chadr/Heathkit-IT-121-Power-Supply/KICAD/1043/3D/1043.stp

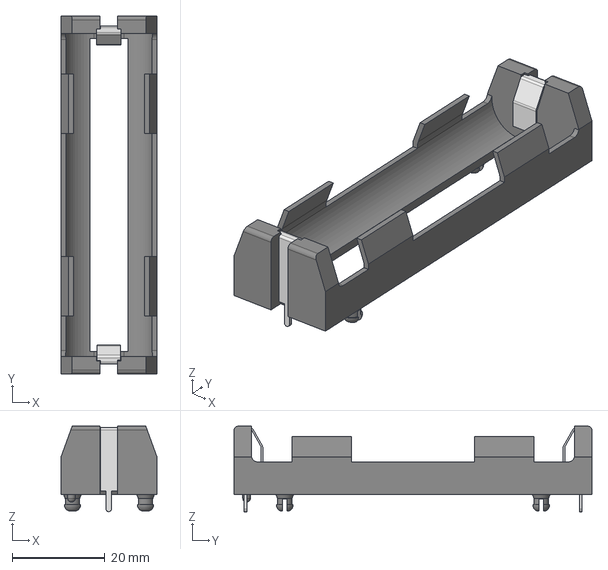
[picture p4: CAD file, 2025-03-20]
KICAD/1043/3D/1043.stp
20.6 x 77.0 x 18.4 mm
