chadr/Heathkit-IT-121-Power-Supply/(list of files, cad)

Other CAD files:
KICAD/1043/Allegro/1043.psm
KICAD/1043/DEHDL/1043/chips/chips.prt
