chadr/Heathkit-IT-121-Power-Supply/(list of files, drawings)

Other design files:
KICAD/1043/Altium/1043.PcbLib
KICAD/1043/Altium/1043.SchLib
