chadr/Heathkit-IT-121-Power-Supply/KICAD/HeathkitBatteryEliminator/HeathkitBatteryEliminator.kicad_pcb

## KiCad design KICAD/HeathkitBatteryEliminator/HeathkitBatteryEliminator.kicad_pcb (2025-03-20)

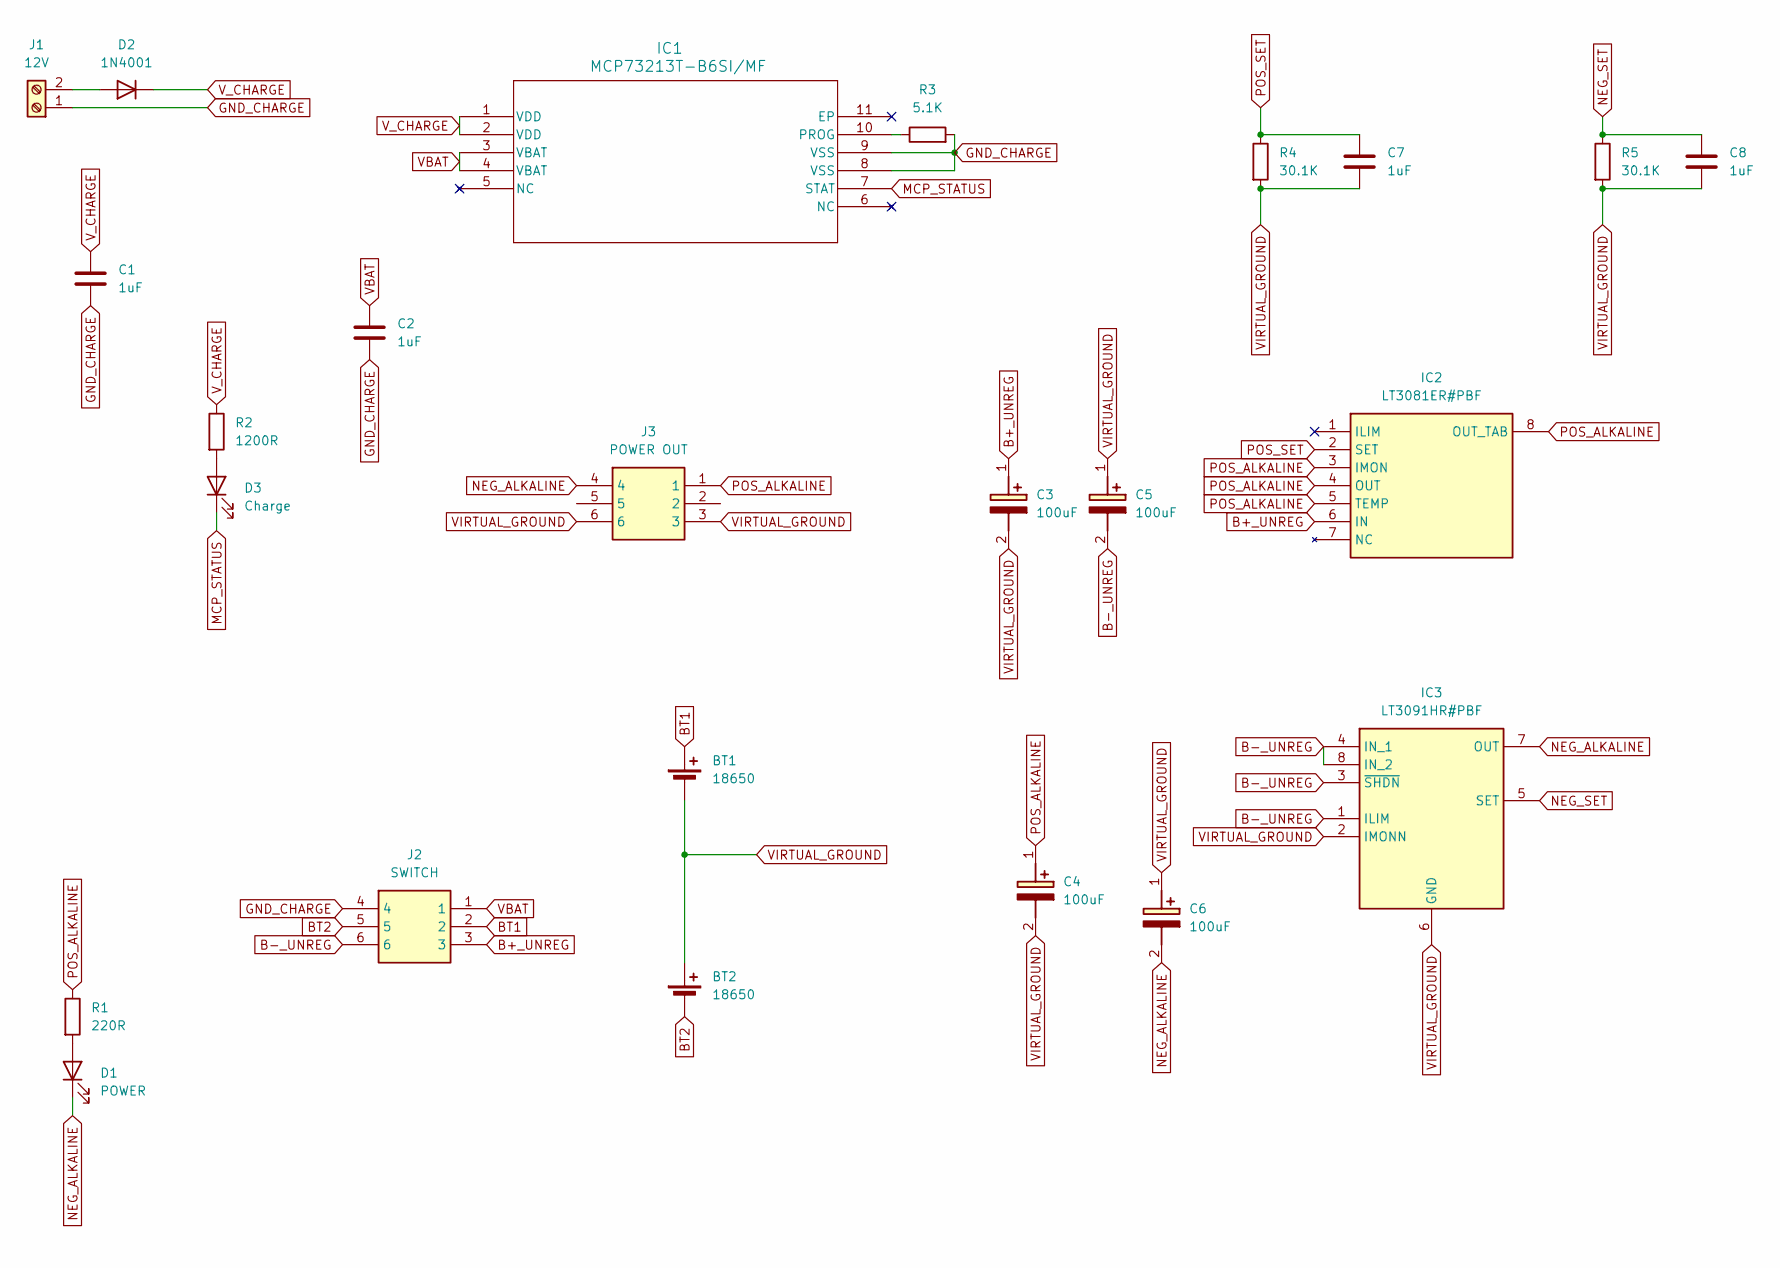
[picture p5: schematic HeathkitBatteryEliminator.kicad_sch]

Parts:
BT1, BT2: 18650; 1043
C1, C2: 1uF; C_0603_1608Metric_Pad1.08x0.95mm_HandSolder
C3, C4, C5, C6: 100uF; 865080343009; Manufacturer_Part_Number 865080343009; Mouser Part Number 710-865080343009
C7, C8: 1uF; C_0603_1608Metric
D1: POWER; PinHeader_2x01_P2.54mm_Vertical
D2: 1N4001; D_DO-41_SOD81_P10.16mm_Horizontal
D3: Charge; PinHeader_2x01_P2.54mm_Vertical
IC1: MCP73213T-B6SI/MF; DFN10_3x3MC_MCH-M
IC2: LT3081ER#PBF; TO127P1394X457-8N; Manufacturer_Part_Number LT3081ER#PBF; Mouser Part Number 584-LT3081ER#PBF
IC3: LT3091HR#PBF; LT3091HRPBF; Manufacturer_Part_Number LT3091HR#PBF; Mouser Part Number 584-LT3091HR#PBF
J1: 12V; TerminalBlock_Phoenix_MKDS-1,5-2-5.08_1x02_P5.08mm_Horizont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
J2: SWITCH; 455580003; Manufacturer_Part_Number 45558-0003; Mouser Part Number 538-45558-0003
J3: POWER OUT; 455580003; Manufacturer_Part_Number 45558-0003; Mouser Part Number 538-45558-0003
R1: 220R; R_0603_1608Metric
R2: 1200R; R_0603_1608Metric
R3: 5.1K; R_0603_1608Metric
R4, R5: 30.1K; R_0603_1608Metric

Connections:
B+_UNREG: C3.1 (+), IC2.6 (IN), J2.3
B-_UNREG: C5.2 (-), IC3.1 (ILIM), IC3.3 (~SHDN), IC3.4 (IN_1), IC3.8 (IN_2), J2.6
BT1: BT1.1 (+), J2.2
BT2: BT2.2 (-), J2.5
GND_CHARGE: C1.2, C2.2, IC1.8 (VSS), IC1.9 (VSS), J1.1, J2.4, R3.2
MCP_STATUS: D3.1 (K), IC1.7 (STAT)
NEG_ALKALINE: C6.2 (-), D1.1 (K), IC3.7 (OUT), J3.4
NEG_SET: C8.1, IC3.5 (SET), R5.1
unnamed: D1.2 (A), R1.2
unnamed: D2.2 (A), J1.2
unnamed: D3.2 (A), R2.2
unnamed: IC1.10 (PROG), R3.1
POS_ALKALINE: C4.1 (+), IC2.3 (IMON), IC2.4 (OUT), IC2.5 (TEMP), IC2.8 (OUT_TAB), J3.1, R1.1
POS_SET: C7.1, IC2.2 (SET), R4.1
VBAT: C2.1, IC1.3 (VBAT), IC1.4 (VBAT), J2.1
VIRTUAL_GROUND: BT1.2 (-), BT2.1 (+), C3.2 (-), C4.2 (-), C5.1 (+), C6.1 (+), C7.2, C8.2, IC3.2 (IMONN), IC3.6 (GND), J3.3, J3.6, R4.2, R5.2
V_CHARGE: C1.1, D2.1 (K), IC1.1 (VDD), IC1.2 (VDD), R2.1

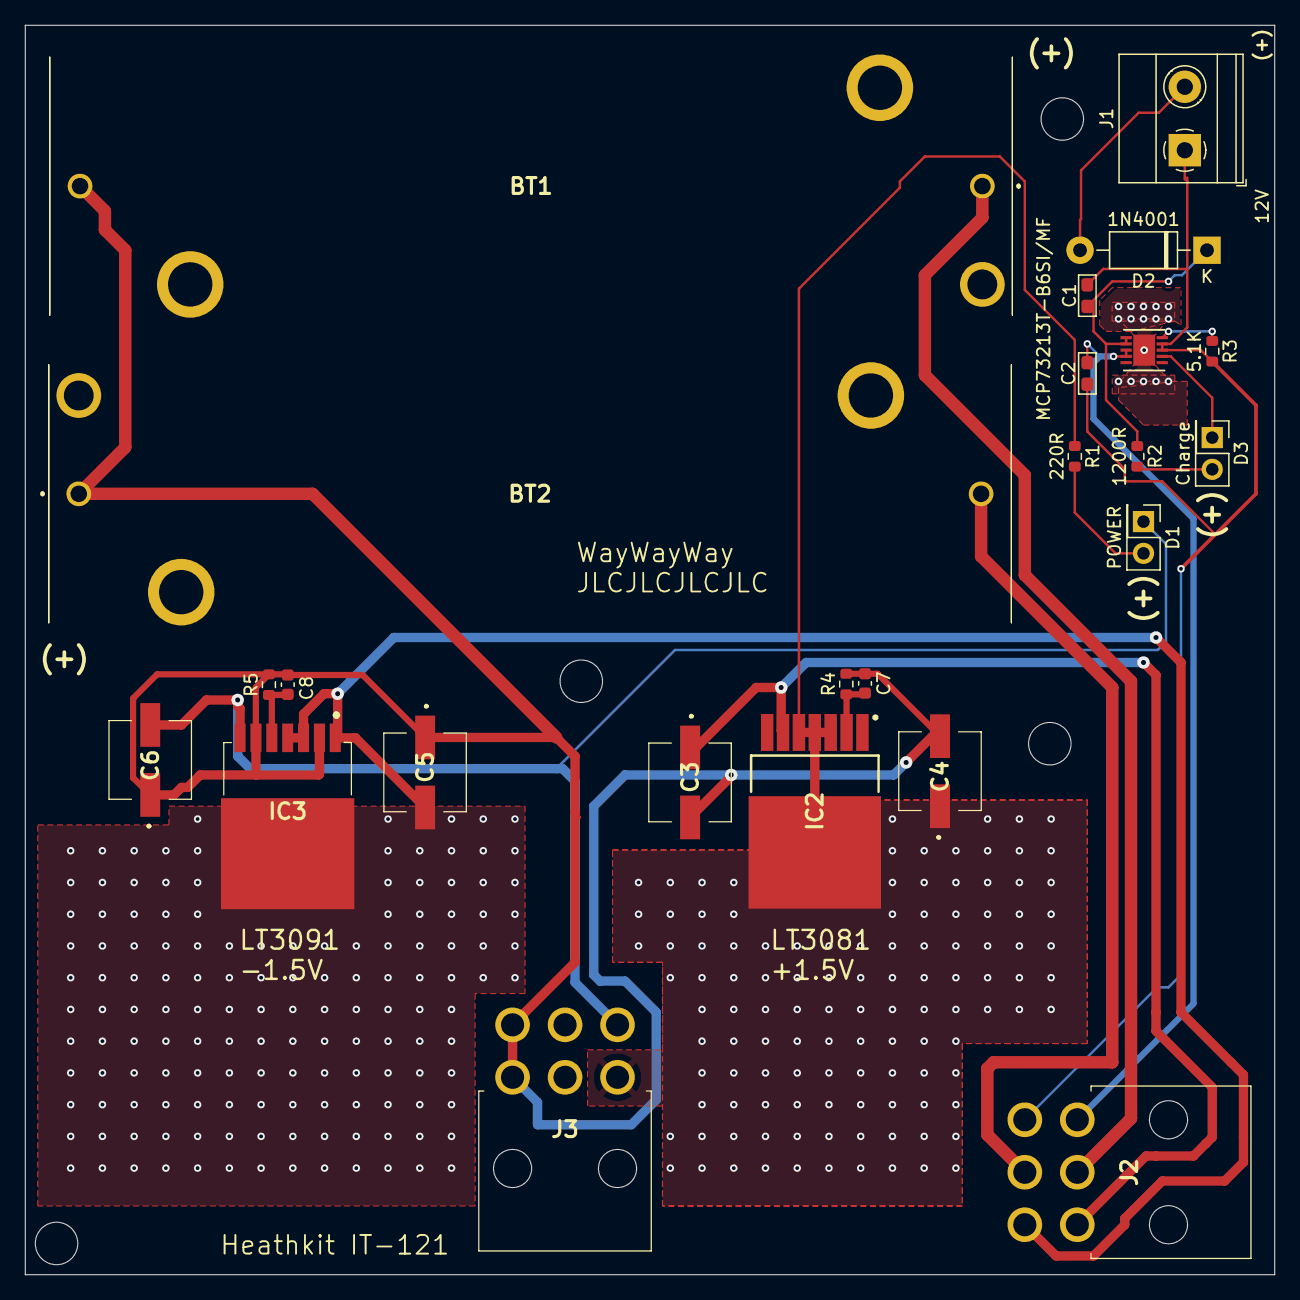
[picture p6: board HeathkitBatteryEliminator.kicad_pcb from above]

Board: 2 copper layers, 100.0 x 100.0 mm, 24 parts (0 on the bottom side), 17 nets.
